gaurav3611/Cric-Pro-Hardware/stages/05_ble_stream/README.pdf

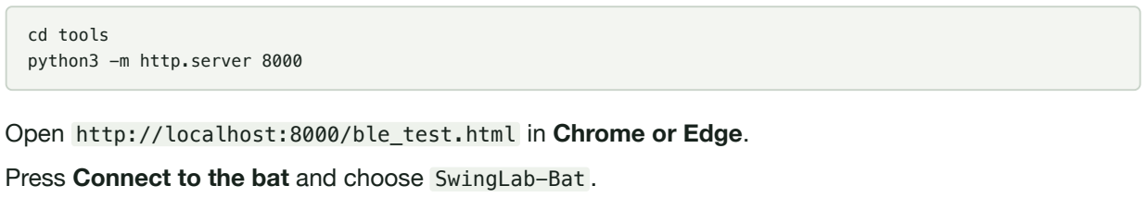
[picture p15: figure]
cd tools python3 -m http.server 8000

SSwinGG bat sensor. Stage 5: send the readings over Bluetooth | 1 / 3

# Stage 5: send the readings over Bluetooth

You add: nothing. Still on the USB cable.

You learn: how a Bluetooth Low Energy device is found, connected to and listened to, and what the 14-byte packet looks like.

How the bat and the dashboard find each other over Bluetooth

Bluetooth Low Energy. The bat is the peripheral: it holds the data. The browser is the central: it connects and listens.

What the bat offers

Device SwingLab-Bat

Service: a folder of values
4fafc201-1fb5-459e-8fcc-c5c9c331914b

Characteristic: one value
beb5483e-36e1-4688-b7f5-ea07361b26a8

14 bytes: the newest reading
can be read, and is pushed (notify)

Service 0x180F: battery, the standard one

only with the stage 7 parts

Characteristic 0x2A19

1 byte: charge in percent, 0 to 100

The long ids were picked at random, once. They only have to be the same in the firmware (config.h) and in the web app (sensor-packet.ts).

1

The bat advertises

A few times a second it broadcasts: my name is SwingLab-Bat, and I offer service 4fafc201. Its light blinks slowly.

2

You press Connect Sensor

The browser lists nearby devices whose name starts with SwingLab. A web page may only see what you pick yourself.

3

The browser connects

From now on the two take turns many times a second. The bat stops advertising and its light stays on.

4

The page finds the value

It asks for the service by its id, then for the characteristic by its id.

5

The page asks for notifications

It flips a small switch on the characteristic that means: push me every new value.

6

The bat sends 14 bytes every 20 ms

Nobody has to ask again. The dashboard uses a packet only while a shot is being recorded.

7

The connection ends

The page closes or goes out of range. The bat starts advertising again by itself.

## Steps

1. Lay the board still. Open 05_ble_stream.ino (https://github.com/gaurav3611/Cric-Pro-Hardware/blob/main/stages/05_ble_stream/05_ble_stream.ino) and upload. The light blinks slowly: it is waiting for a connection.
2. On the computer, serve the test page. It has to come from localhost , because browsers block Bluetooth for pages opened as files. In a terminal, from this kit's folder:
3. Open http://localhost:8000/ble_test.html in Chrome or Edge.
4. Press Connect to the bat and choose SwingLab-Bat .
5. Swing the board.

No computer nearby? The phone app nRF Connect also works: scan, connect to SwingLab-Bat , open the service, and switch notifications on for its one value.

## What you should see

On the board, the light goes steady. In the Serial Monitor:

SSwinGG bat sensor. Stage 5: send the readings over Bluetooth | 2 / 3

===== Stage 5: Bluetooth stream ===== BMI160 found at 0x68
Keep the board still for one second...
Bluetooth is on. Look for "SwingLab-Bat".
waiting sent 0/s failed reads 0 last packet: 2F 00 AB FF 0E 10 01 00 00 00 00 00 00 00 connected sent 12/s failed reads 0 last packet: 32 00 AF FF 13 10 00 00 FF FF 01 00 00 00 connected sent 50/s failed reads 0 last packet: 35 05 72 03 12 10 40 FD 06 0B 4C 01 00 00 connected sent 50/s failed reads 0 last packet: 2F 00 AB FF 0E 10 02 00 01 00 01 00 00 00 Disconnected. Advertising again.
waiting sent 13/s failed reads 0 last packet: 34 00 AF FF 11 10 02 00 00 00 01 00 00 00

On the test page:

about 50 readings per second
all four checks pass while the board lies still
the table "The last packet, taken apart" shows the same bytes as the Serial Monitor, split into seven numbers
a swing makes the bat speed rise and the chart draw a peak

The stage is passed when the page shows 50 readings a second and a speed of 0 at rest.

"Try with a simulated bat" on the page shows what a working connection looks like, with numbers the page makes up itself.

## What is going on

The 14-byte packet

What the bat sends 50 times a second, and how the dashboard reads it. The example was taken during a swing.

35

byte 0
05

byte 1
72

byte 2
03

byte 3
12

byte 4
10

byte 5
40

byte 6
FD

byte 7
06

byte 8
0B

byte 9
4C

byte 10
01

byte 11
00

byte 12
00

byte 13

ax
0x0535

= 1333 counts
/ 4096
+0.325 g

ay
0x0372

= 882 counts
/ 4096
+0.215 g

az
0x1012

= 4114 counts
/ 4096
+1.004 g

gx
0xFD40

= -704 counts
/ 16.4
-42.9 deg/s

gy
0x0B06

= 2822 counts
/ 16.4
+172.1 deg/s

gz
0x014C

= 332 counts
/ 16.4
+20.2 deg/s

temperature
0x0000

= 0 counts
not used by
the dashboard

What the dashboard does with these six numbers

Total rotation = square root of gx squared + gy squared + gz squared = 178.5 degrees per second

Bat speed = total rotation x pi / 180 x 0.85 m x 3.6 = 9.5 km/h

Impact = square root of ax squared + ay squared + az squared = 1.08 g

Shot direction = leg side if gz is above +1, off side if below -1, otherwise straight = leg side

Low byte first. The number 0x0B06 travels as 06 then 0B. Both ends must agree on this, and on the order of the seven numbers.

Signed. Each number runs from -32768 to +32767. A value with its top bit set is negative: 0xFD40 is -704.

Why counts and not units. Seven whole numbers fit in 14 bytes. The same values as text, as stage 9 sends them over WiFi, need about 110 bytes.

The scale, 4096 and 16.4, comes from the sensor's ranges of 8 g and 2000 degrees per second. Change a range and both ends have to change.

Advertising. BLEDevice::startAdvertising() makes the board broadcast its name and the id of its service a few times a second.
Server, service, characteristic. The board holds the data, so it is the server. The sketch creates one service, a folder, and in it one characteristic, a value. Both are named by a long id that the dashboard asks for by heart.
Notify. Every 20 milliseconds the sketch puts a new 14-byte value into the characteristic and calls notify() . The connected browser receives it without asking.

SSwinGG bat sensor. Stage 5: send the readings over Bluetooth | 3 / 3

The packet. Seven 16-bit numbers, low byte first: ax, ay, az, gx, gy, gz, temperature. swing_packet.h builds it. The browser divides the first three by 4096 and the next three by 16.4.
Callbacks. onConnect and onDisconnect are called by the Bluetooth code when someone arrives or leaves. They only set a flag, and loop() acts on it.
Two radios, one chip. Bluetooth is built into the ESP32-C3. No part was added for this stage.

## Try this

Compare the "last packet" line in the Serial Monitor with the table on the test page. Work one value out by hand.
Change SAMPLE_PERIOD_MS to 100 and upload. The page now shows 10 readings a second and its first check fails. Put it back to 20.
Close the test page. The board prints "Disconnected. Advertising again." and the light blinks again.

## If it does not work

See Bluetooth. (https://github.com/gaurav3611/Cric-Pro-Hardware/blob/main/docs/troubleshooting.pdf)

Next: stage 6. (https://github.com/gaurav3611/Cric-Pro-Hardware/blob/main/stages/06_battery_power/README.pdf)
