gaurav3611/Cric-Pro-Hardware/stages/07_battery_level/README.pdf

SSwinGG bat sensor. Stage 7, optional: measure the battery | 1 / 2

# Stage 7, optional: measure the battery

You add: two 100 kilohm resistors and one 100 nanofarad capacitor.

You learn: how a chip measures a voltage, and why the measurement has to be compared with a multimeter once.

Skip this stage if you do not need a battery reading. The bat works without it.

Stage 7 (optional): measuring the battery

Two equal resistors halve the battery voltage, so the pin never sees more than it can take.

switch output
battery +

3.3 to 4.2 V

R1

100 k

R2

100 k

GND

ESP32 GPIO0 1.65 to 2.1 V

C1
100 nF

How it works

The same small current flows through R1 and then R2. Because they are equal, each drops half of the battery voltage. The point between them is at half.

pin = battery x R2 / (R1 + R2)

4.2 V at the battery is 2.1 V at the pin. The pin measures up to about 2.5 V.

The firmware multiplies by 2 again.
C1 holds the voltage steady for the moment the chip takes its measurement.

Take the battery voltage after the switch and before the diode. Then the resistors draw nothing while the bat is switched off.

With 200 kilohm in total they draw 21 millionths of an amp while it is on, which the cell does not notice.

Resistors are never exactly equal. Stage 7 shows how to compare with a multimeter once and correct the difference.

Change the resistors and the firmware has to know: BATTERY_DIVIDER_RATIO in config.h is (R1 + R2) / R2.

## Steps

1. Switch the battery off and unplug USB.
2. Solder R1, R2 and C1 as in session 3 of build-on-zero-pcb.pdf. (https://github.com/gaurav3611/Cric-Pro-Hardware/blob/main/docs/build-on-zero-pcb.pdf)
3. Check with the multimeter, battery switched on: the point between R1 and R2 must read half the cell voltage, so between 1.65 and 2.1 volts. If it reads the full cell voltage, R2 is not joined to ground. Do not go on until this is right: a GPIO pin must never see more than 3.3 volts.
4. Upload 07_battery_level.ino (https://github.com/gaurav3611/Cric-Pro-Hardware/blob/main/stages/07_battery_level/07_battery_level.ino) and open the Serial Monitor, with the battery switched on.
5. Measure the cell with the multimeter, from the charger's OUT+ to OUT- , and compare.

## What you should see

===== Stage 7: battery level =====
Measuring on GPIO0. Divider ratio 2.0, calibration 1.000
Switch the battery on. Compare the volts below with a multimeter on the battery.
pin | 3 mV | no battery seen. Is the switch on, and are R1 and R2 fitted?
pin 2060 mV | battery 4.12 V | 92% | ok
pin 1780 mV | battery 3.56 V | 8% | low: charge soon
pin 1705 mV | battery 3.41 V | 0% | EMPTY: switch off and charge

SSwinGG bat sensor. Stage 7, optional: measure the battery | 2 / 2

The four lines show the four states. On your board you will see one of them, and it changes only as the cell drains.

The stage is passed when the printed voltage is within 0.05 volts of the multimeter.

## Calibrate

Resistors are never exactly equal, so the printed voltage is usually a little off.

CALIBRATION = multimeter volts / printed volts

For example, 4.08 on the multimeter and 4.00 printed gives 1.020. Put that number in the sketch, upload, and check that the two now agree. Write it down: stage 8 needs the same number.

## What is going on

An ADC turns a voltage into a number. On this chip GPIO0 to GPIO4 can do that, up to about 2.5 volts. The two resistors halve the battery voltage, so 4.2 volts becomes 2.1. The sketch multiplies by 2 again. The capacitor keeps the middle point steady for the instant the chip measures.
Averaging. The sketch takes 32 measurements and averages them, because one alone is noisy. Percent is a rough guide. The voltage of a LiPo cell does not fall in a straight line, so battery.h looks it up in a small table. The voltage also dips while the radio sends.
Where the wire is taken from. After the switch, so the resistors draw nothing when the bat is off. Before the diode, so it is the cell's own voltage.

## Try this

Watch the voltage for a minute with Bluetooth off. Then compare with stage 8 running: it reads slightly lower under load.
Switch the battery off while the USB cable keeps the board running. The sketch says "no battery seen".

## If it does not work

See The battery. (https://github.com/gaurav3611/Cric-Pro-Hardware/blob/main/docs/troubleshooting.pdf)

Next: stage 8. (https://github.com/gaurav3611/Cric-Pro-Hardware/blob/main/stages/08_sswingg_bat/README.pdf)
