gaurav3611/Cric-Pro-Hardware/pcb/bom.csv

Ref | Value | Qty | Name to search for | Notes | Footprint
BT1 | LiPo 3.7 V 1500 mAh | 1 | 3.7 V 1500 mAh LiPo cell, size 803450, with protection board | Taped to the back of the board in its marked place, on foam tape, after every lead there is cut short. Plugs into J1.
C1 | 100nF | 1 | 100 nF ceramic capacitor, 50 V, printed 104 | Optional, battery reading of stage 7. | Capacitor_THT:C_Disc_D5.0mm_W2.5mm_P5.00mm
C2 | 220uF 10V | 1 | 220 uF electrolytic capacitor, 10 V or more, 6.3 mm across | Holds the 5V line up while the radio sends. Plus lead in the square pad. | Capacitor_THT:CP_Radial_D6.3mm_P2.50mm
D1 | 1N5817 | 1 | 1N5817 Schottky diode, 1 A, 20 V (1N5819 also works) | Lets the battery and the ESP32's USB cable be connected at the same time. Stripe on the square pad. | Diode_THT:D_DO-41_SOD81_P10.16mm_Horizontal
J1 | Battery | 1 | JST PH 2.0 mm 2-pin socket, vertical (B2B-PH-K) | The battery plugs in here. Check the plug's + and - with a multimeter first: makers wire them both ways. | Connector_JST:JST_PH_B2B-PH-K_1x02_P2.00mm_Vertical
R1,R2 | 100k 1% | 2 | 100 kilohm resistor, 1/4 W, 1 %, metal film | Optional, battery reading of stage 7. | Resistor_THT:R_Axial_DIN0207_L6.3mm_D2.5mm_P10.16mm_Horizontal
SW1 | SS12D00G3 | 1 | SS12D00G3 slide switch, SPDT, 3 pins, 2.54 mm | In the plus wire, after the charger, so the cell can charge with the bat off. | sswingg:SW_Slide_SS12D00G3
U1 | ESP32-C3 Super Mini | 1 | ESP32-C3 Super Mini development board | Plugs into two 1x8 female headers, 2.54 mm. Buy the headers too. USB-C end at the board edge. | sswingg:ESP32-C3_SuperMini_Socket
U2 | GY-BMI160 | 1 | GY-BMI160 6-axis module (Bosch BMI160) | Plugs into a 1x7 and a 1x5 female header, 2.54 mm. The 5-pin row only holds it level. Not an MPU6050. | sswingg:GY-BMI160_Socket
U3 | TP4056 module | 1 | TP4056 charger module with protection, 1 A, USB Type-C | On foam tape in its marked space, USB-C at the left edge. Four short wires from its OUT+, B+, B- and OUT- to the pads beside it. Any maker's module fits. | sswingg:TP4056_Module_Wired
