gaurav3611/Cric-Pro-Hardware/tools/ble_test.html

# SSwinGG bat sensor test

Connects to the bat over Bluetooth and shows what it sends, read exactly the way the dashboard reads it. No sign-in needed. Use it with stage 5 and stage 8.

Connect to the bat Disconnect Try with a simulated bat Not connected.

## Checks

- waitingReadings arrive about 50 times a second.
- waitingEach packet is 14 bytes or more.
- waitingHeld still, total acceleration is close to 1 g.
- waitingHeld still, bat speed is 0.

The last two only mean something while the bat is lying still. Then swing it and watch the speed.

## Live values

Bat speed

0.0 km/h

Peak speed

0.0 km/h

Total acceleration

0.00 g

Total rotation

0 deg/s

Shot direction

Readings per second

0

Battery

ax

0.00 g

ay

0.00 g

az

0.00 g

gx

0 deg/s

gy

0 deg/s

gz

0 deg/s

Reset peak Total packets: 0. Last packet: -

## The last packet, taken apart

Value | Bytes, as sent | As one number | Counts | Divided by | Result

Each value is two bytes, low byte first. This table is refreshed five times a second, the packets arrive ten times as often.

## Bat speed, last 8 seconds

## Log
