gaurav3611/Cric-Pro-Hardware/pcb/sswingg-bat.kicad_pcb

## KiCad design pcb/sswingg-bat.kicad_pcb (2026-10-22)

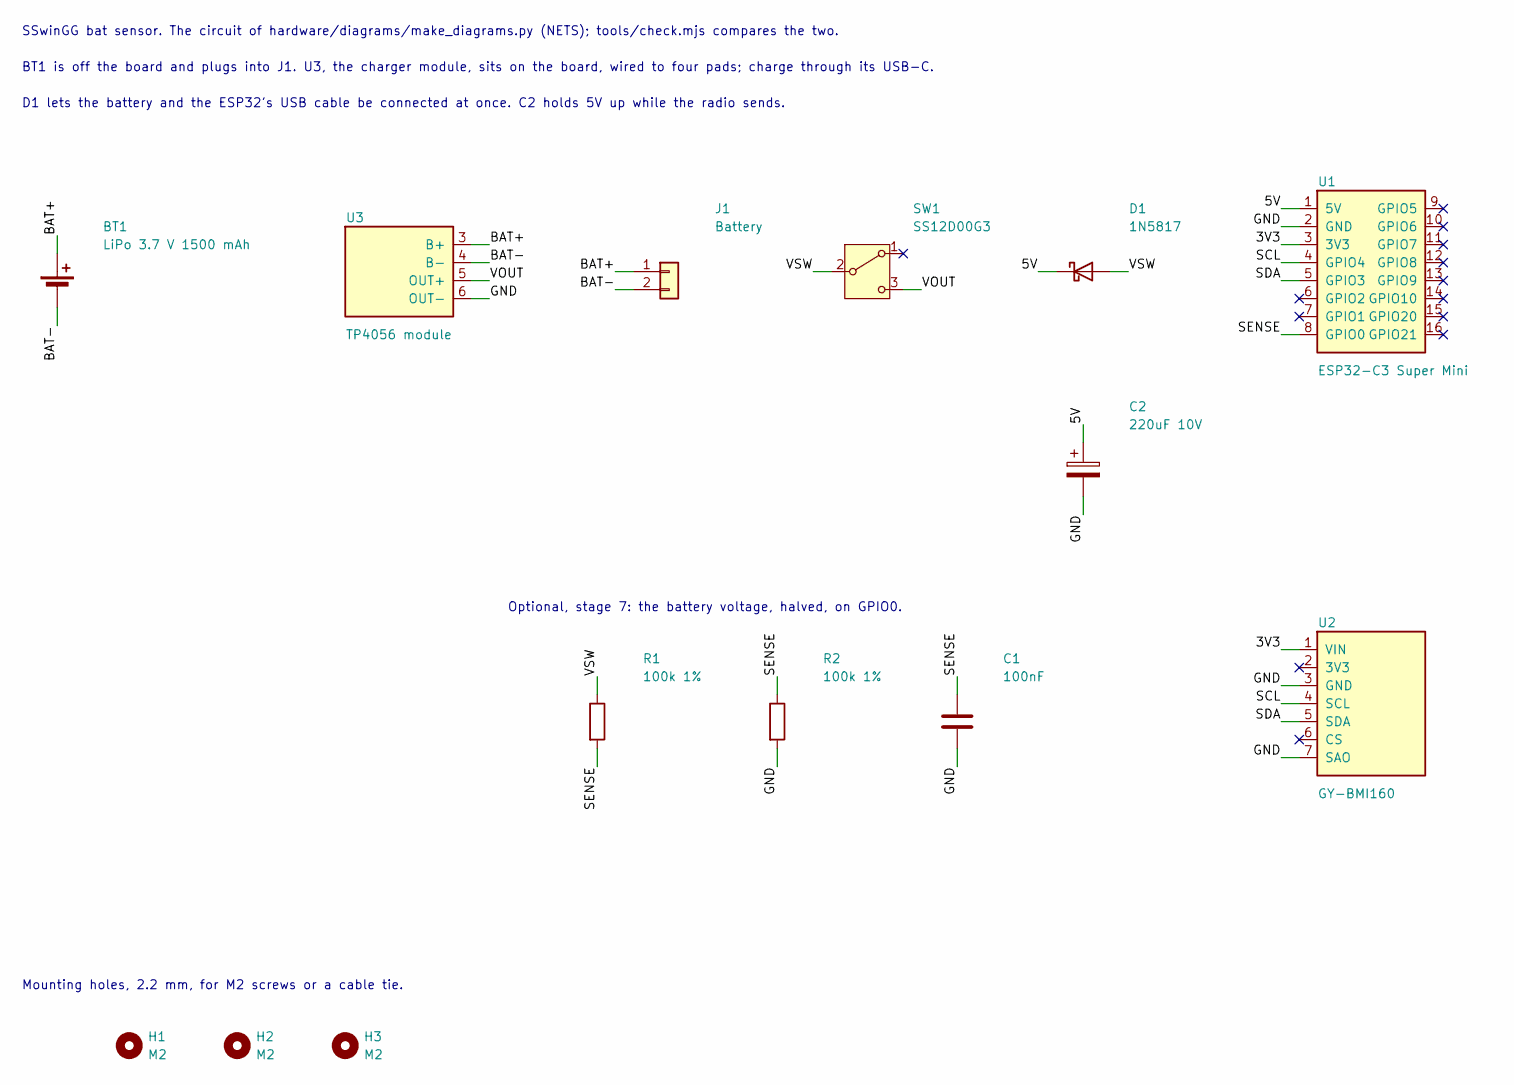
[picture p23: schematic sswingg-bat.kicad_sch, SSwinGG bat sensor]

Parts:
BT1: LiPo 3.7 V 1500 mAh
C1: 100nF; C_Disc_D5.0mm_W2.5mm_P5.00mm
C2: 220uF 10V; CP_Radial_D6.3mm_P2.50mm
D1: 1N5817; D_DO-41_SOD81_P10.16mm_Horizontal
H1, H2, H3: M2; MountingHole_2.2mm_M2
J1: Battery; JST_PH_B2B-PH-K_1x02_P2.00mm_Vertical
R1, R2: 100k 1%; R_Axial_DIN0207_L6.3mm_D2.5mm_P10.16mm_Horizontal
SW1: SS12D00G3; SW_Slide_SS12D00G3
U1: ESP32-C3 Super Mini; ESP32-C3_SuperMini_Socket
U2: GY-BMI160; GY-BMI160_Socket
U3: TP4056 module; TP4056_Module_Wired

Connections:
/3V3: U1.3 (3V3), U2.1 (VIN)
/5V: C2.1, D1.1 (K), U1.1 (5V)
/BAT+: BT1.1 (+), J1.1, U3.3 (B+)
/BAT-: BT1.2 (-), J1.2, U3.4 (B-)
/GND: C1.2, C2.2, R2.2, U1.2 (GND), U2.3 (GND), U2.7 (SAO), U3.6 (OUT-)
/SCL: U1.4 (GPIO4), U2.4 (SCL)
/SDA: U1.5 (GPIO3), U2.5 (SDA)
/SENSE: C1.1, R1.2, R2.1, U1.8 (GPIO0)
/VOUT: SW1.3 (C), U3.5 (OUT+)
/VSW: D1.2 (A), R1.1, SW1.2 (B)

Notes on the sheet:
SSwinGG bat sensor. The circuit of hardware/diagrams/make_diagrams.py (NETS); tools/check.mjs compares the two.
BT1 is off the board and plugs into J1. U3, the charger module, sits on the board, wired to four pads; charge through its USB-C.
D1 lets the battery and the ESP32's USB cable be connected at once. C2 holds 5V up while the radio sends.
Optional, stage 7: the battery voltage, halved, on GPIO0.
Mounting holes, 2.2 mm, for M2 screws or a cable tie.

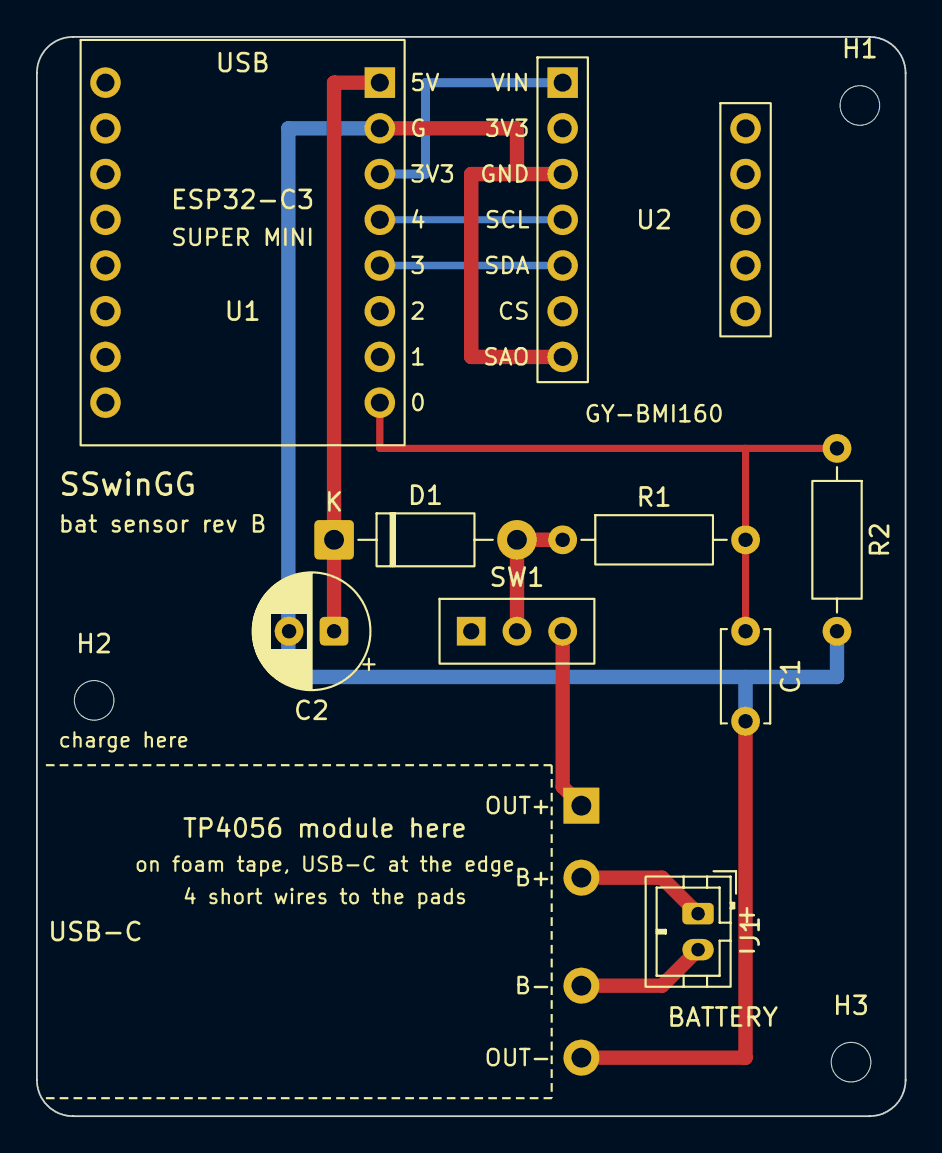
[picture p24: board sswingg-bat.kicad_pcb from above]

Board: 2 copper layers, 48.3 x 60.0 mm, 13 parts (0 on the bottom side), 10 nets.
