gaurav3611/Cric-Pro-Hardware/(commit log)

2026-10-11 SwingLab bat sensor: circuit, firmware and a stage-by-stage guide
    An ESP32-C3 Super Mini with a GY-BMI160 motion sensor, powered by a
    1500 mAh LiPo cell through a TP4056 charger, a slide switch and a diode.
    It sends 50 readings a second over Bluetooth in the 14-byte packet the
    SwingLab dashboard reads.
    - stages/: nine Arduino sketches, from a blink test to the bat firmware,
    each with a page that says what to wire, what to expect and why
    - diagrams/: ten SVG drawings and the script that draws them. The zero
    PCB layout is checked against the circuit before it is drawn.
    - docs/: parts to buy, soldering guide, how it works, how to change it,
    troubleshooting
    - tools/: a Bluetooth test page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
2026-10-11 Publish the guides and stage pages as PDF
    README.md stays as the front page of the repository. Every other
    document is now a PDF: the five guides in docs/ and the page of each of
    the nine stages, with the drawings embedded and the links pointing at
    the files in the repository. diagrams/diagrams.pdf holds all ten
    drawings, one per page, for printing.
    tools/make_pdfs.mjs makes the PDFs from their Markdown sources, which
    are no longer in the repository. tools/check.mjs fails when a PDF is
    older than its source, and skips the source checks in a copy that has
    no sources.
    [03_imu_read.ino, config.h]
2026-10-17 Add the phone recorder, a one-file firmware, a no-diode layout and a tester
    - app/: SwingLab recorder as a web page for Chrome on Android. It records
    each shot from the bat over Bluetooth and saves it as a CSV file. Its
    logic, app/recorder.js, is tested by tools/check.mjs, and
    docs/phone-app.pdf explains it. The Flutter version of the same app is
    in its own repository, gaurav3611/mobile_app_swing.
    - swinglab_bat_one_file/: the stage 8 firmware merged into one sketch,
    made by tools/make_one_file.mjs. The check fails when it falls behind.
    - diagrams/zero-pcb-layout-no-diode.svg: the zero PCB layout with a wire
    in place of the diode, checked for shorts by the drawing script. The
    s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
    [continuity_tester.ino, make_diagrams.py, swinglab_bat_one_file.ino]
2026-10-21 Version 0.2.0: C2 on the PCB, an impact sensor proposal, DevKit tester
    - C2, 220 uF from 5V to GND at H13 and G13, in both zero PCB layouts and
    the full circuit, checked by the layout script.
    - A diagram for a piezo impact sensor wired without diodes. The firmware
    does not read it yet.
    - The continuity tester runs on an ESP32 DevKit as well.
2026-10-22 Rename SwingLab to SSwinGG, and add the PCB as a KiCad 10 project
    The stage 8 folder and the one-file sketch are now sswingg_bat. The
    Bluetooth device names stay SwingLab-Bat, so flashed bats keep pairing.
    pcb/ holds the board: ESP32-C3 Super Mini and GY-BMI160 in sockets, the
    TP4056 module on foam tape wired to four pads, a JST PH battery socket,
    and the cell's place marked on the back. tools/make_pcb_files.mjs runs
    ERC, DRC and a check against NETS, then makes the Gerber zip, the BOM
    and the drawings. check.mjs runs the same checks when KiCad is there.
    [bom.csv, sswingg-bat.kicad_pcb, sswingg-bat.kicad_sch]
